Isla7940-s/mechanical-engineering/ball-valve/video/img/body.jpg

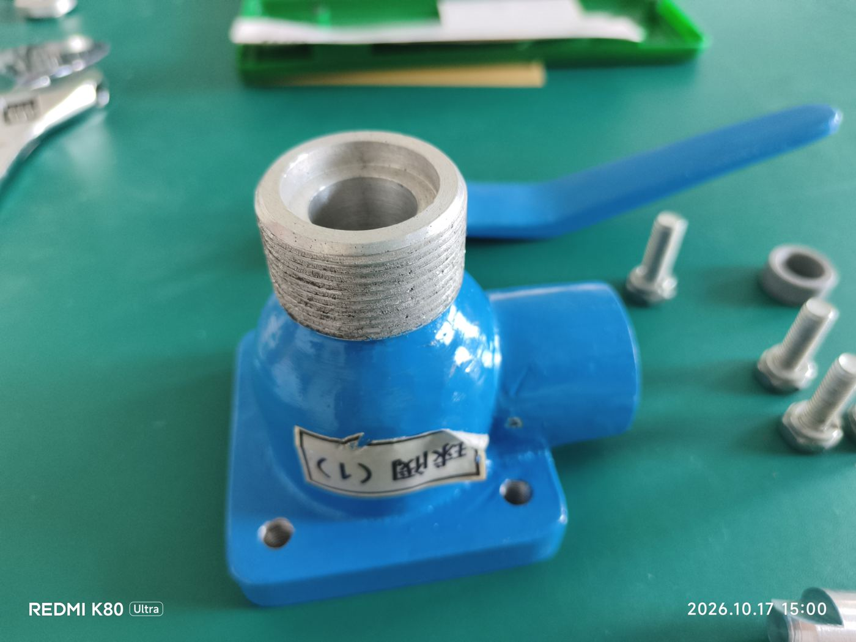
ball-valve/video/img/body.jpg
