Isla7940-s/mechanical-engineering/ball-valve/video-iphone4/img/cover_caliper.jpg

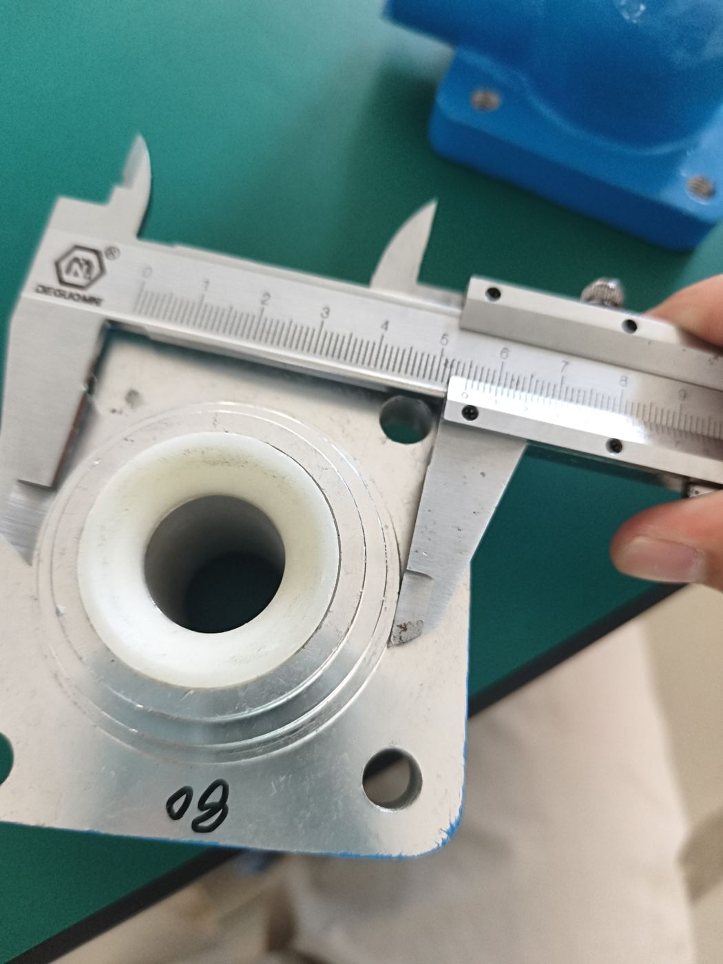
ball-valve/video-iphone4/img/cover_caliper.jpg
