Isla7940-s/mechanical-engineering/README.md

# mechanical-engineering
Repository for mechanical engineering projects, designs, and documentation.
