Isla7940-s/mechanical-engineering/ball-valve/cad/renders/球阀_模型效果图.png

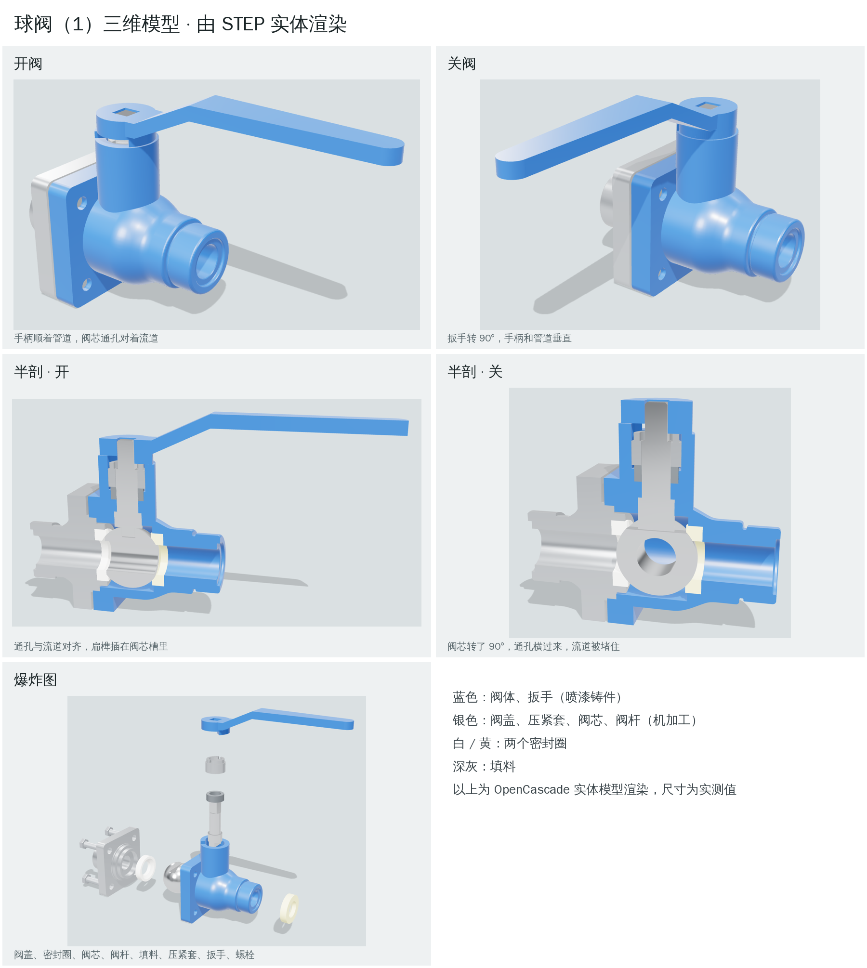
ball-valve/cad/renders/球阀_模型效果图.png
