Isla7940-s/mechanical-engineering/ball-valve/cad/renders/球阀_零件模型图.png

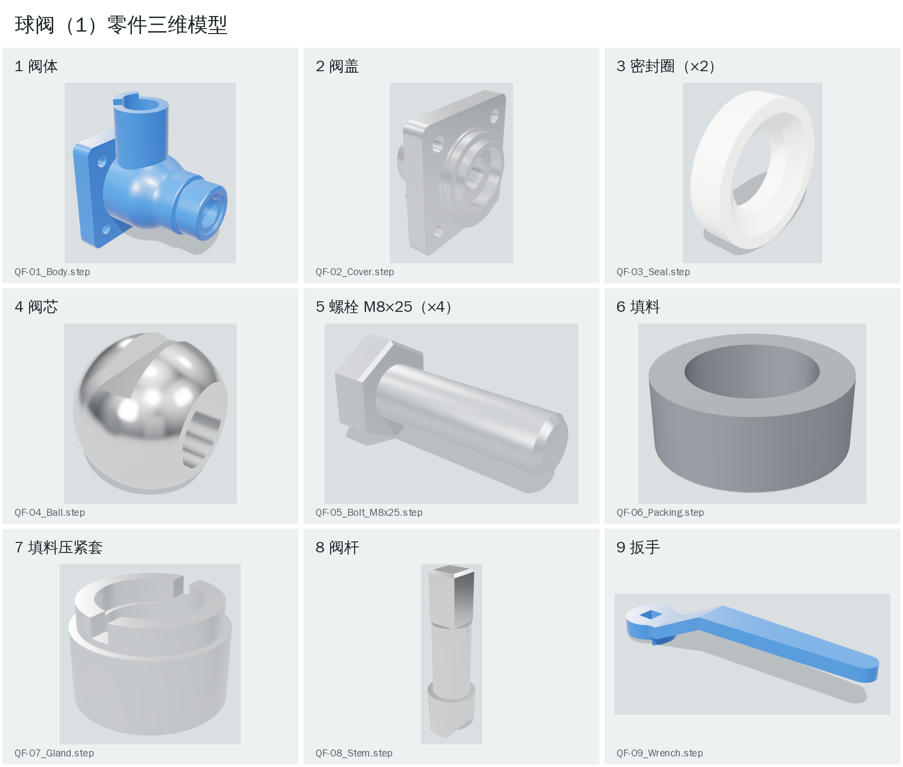
ball-valve/cad/renders/球阀_零件模型图.png
