Isla7940-s/mechanical-engineering/ball-valve/video/img/wrench_caliper.jpg

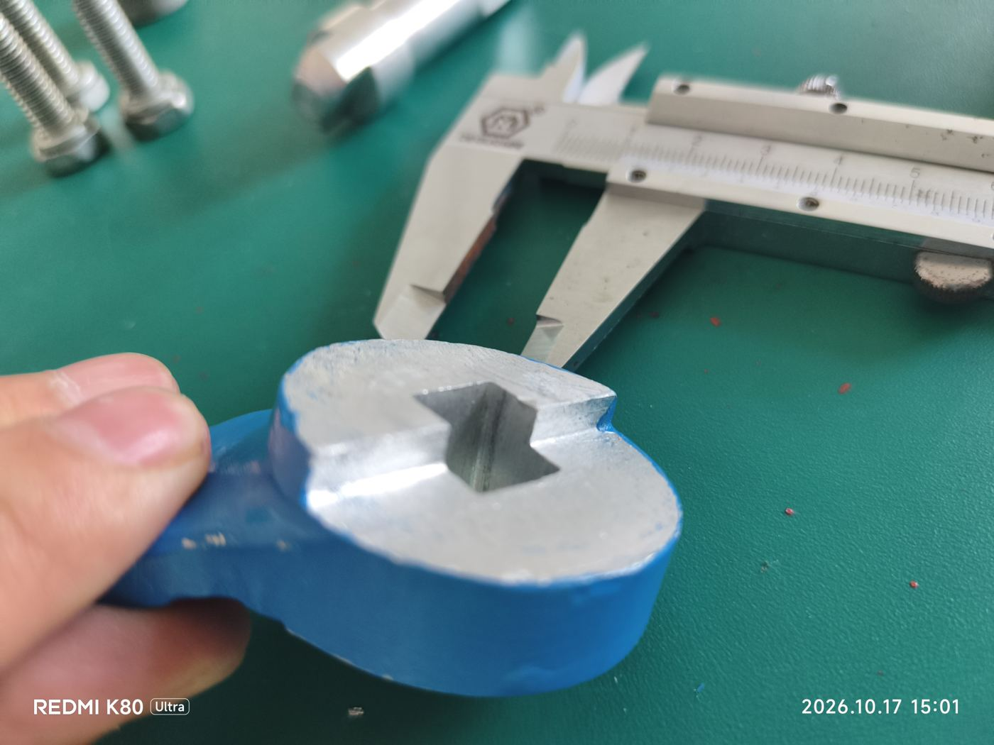
ball-valve/video/img/wrench_caliper.jpg
