Isla7940-s/mechanical-engineering/ball-valve/cad/step/QF-00_Ball_Valve_Assembly.step

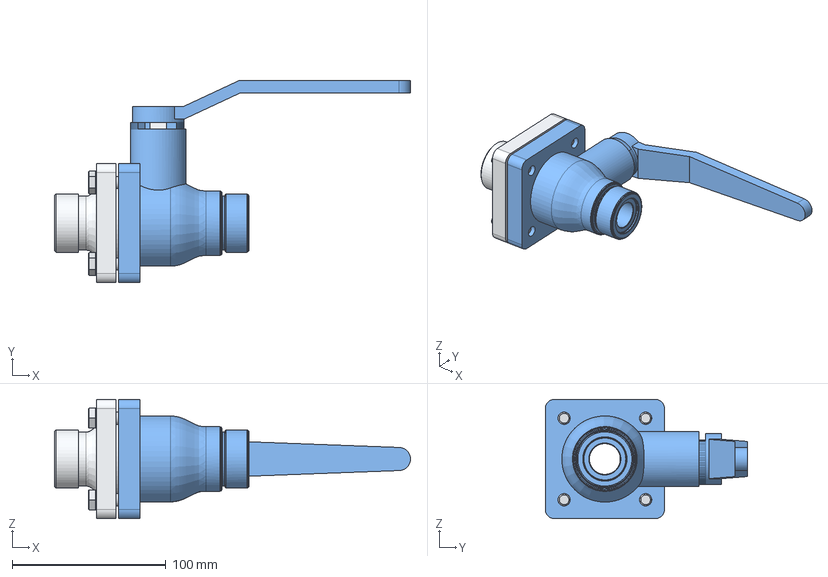
[picture p6: CAD file, 2026-10-21]
ball-valve/cad/step/QF-00_Ball_Valve_Assembly.step
231.4 x 131.6 x 77.5 mm
QF-01_Body
QF-02_Cover
QF-04_Ball
QF-06_Packing
QF-07_Gland
QF-08_Stem
QF-09_Wrench
QF-03_Seal-1
QF-03_Seal-2
QF-05_Bolt-1 x 4
