Isla7940-s/mechanical-engineering/ball-valve/cad/dxf/QF-08_阀杆.dxf

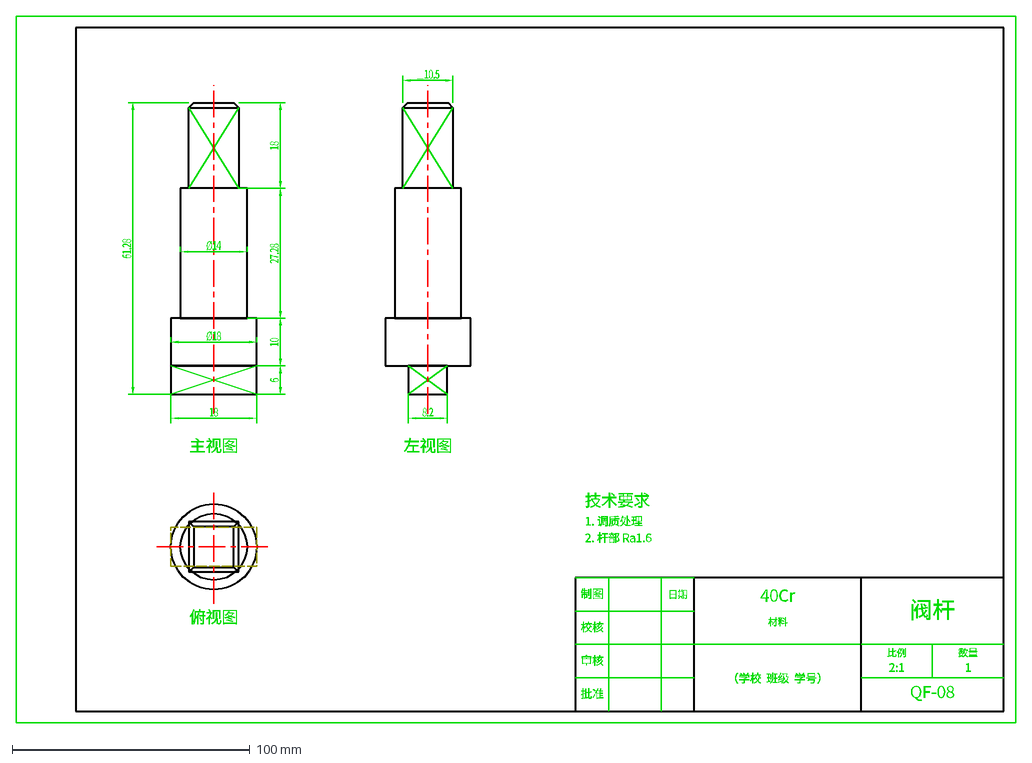
[picture p7: CAD file, 2026-10-21]
ball-valve/cad/dxf/QF-08_阀杆.dxf
61.28
6
10
27.28
18
Ø14
Ø18
主视图
8.2
□10.5
左视图
俯视图
批准
审核
校核
制图
日期
40Cr
材料
（学校 班级 学号）
阀杆
比例
2:1
数量
1
QF-08
技术要求
1. 调质处理
2. 杆部 Ra1.6
