Isla7940-s/mechanical-engineering/ball-valve/cad/step/QF-06_Packing.step

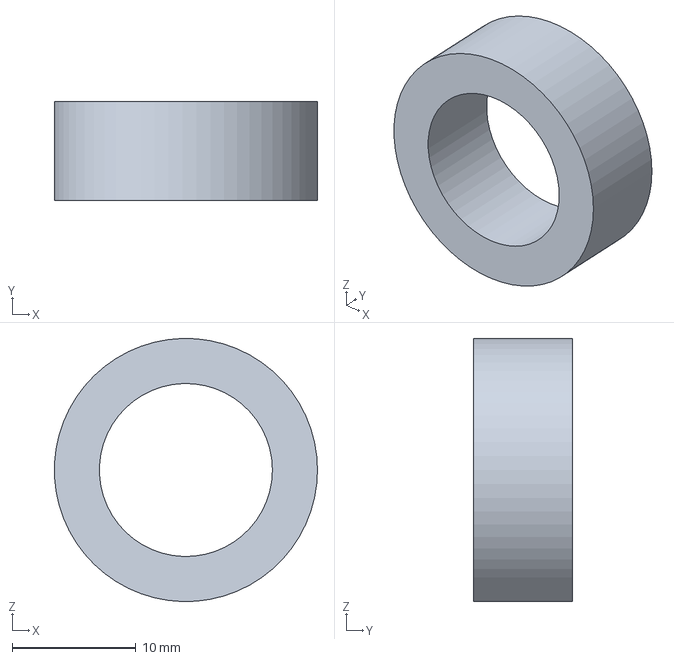
[picture p8: CAD file, 2026-10-21]
ball-valve/cad/step/QF-06_Packing.step
21.3 x 8.00 x 21.3 mm
