Isla7940-s/mechanical-engineering/ball-valve/cad/dxf/QF-03_密封圈.dxf

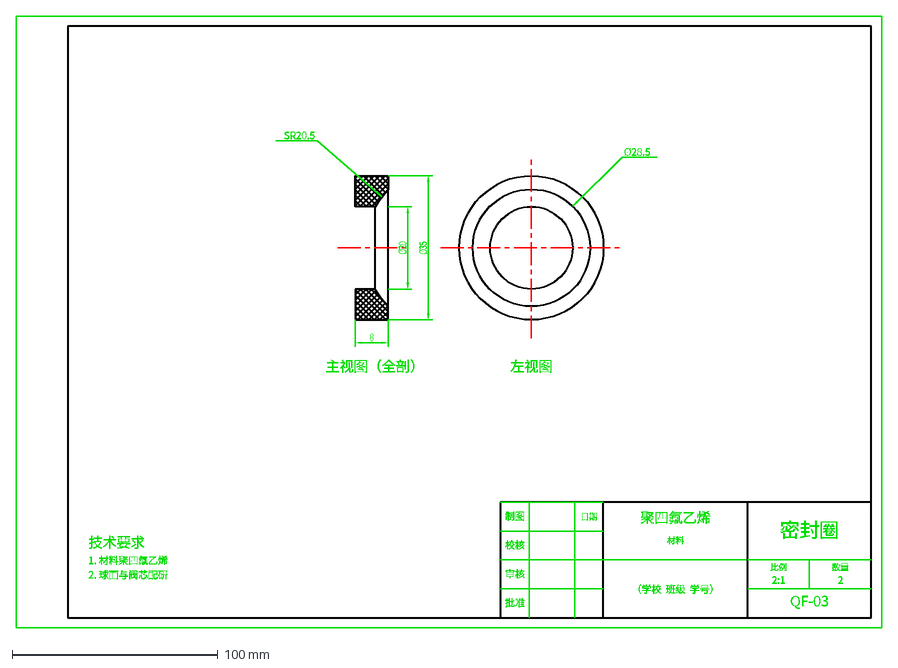
[picture p9: CAD file, 2026-10-21]
ball-valve/cad/dxf/QF-03_密封圈.dxf
8
Ø20
Ø35
SR20.5
主视图（全剖）
Ø28.5
左视图
批准
审核
校核
制图
日期
聚四氟乙烯
材料
（学校 班级 学号）
密封圈
比例
2:1
数量
2
QF-03
技术要求
1. 材料聚四氟乙烯
2. 球面与阀芯配研
