Isla7940-s/mechanical-engineering/ball-valve/cad/dxf/QF-02_阀盖.dxf

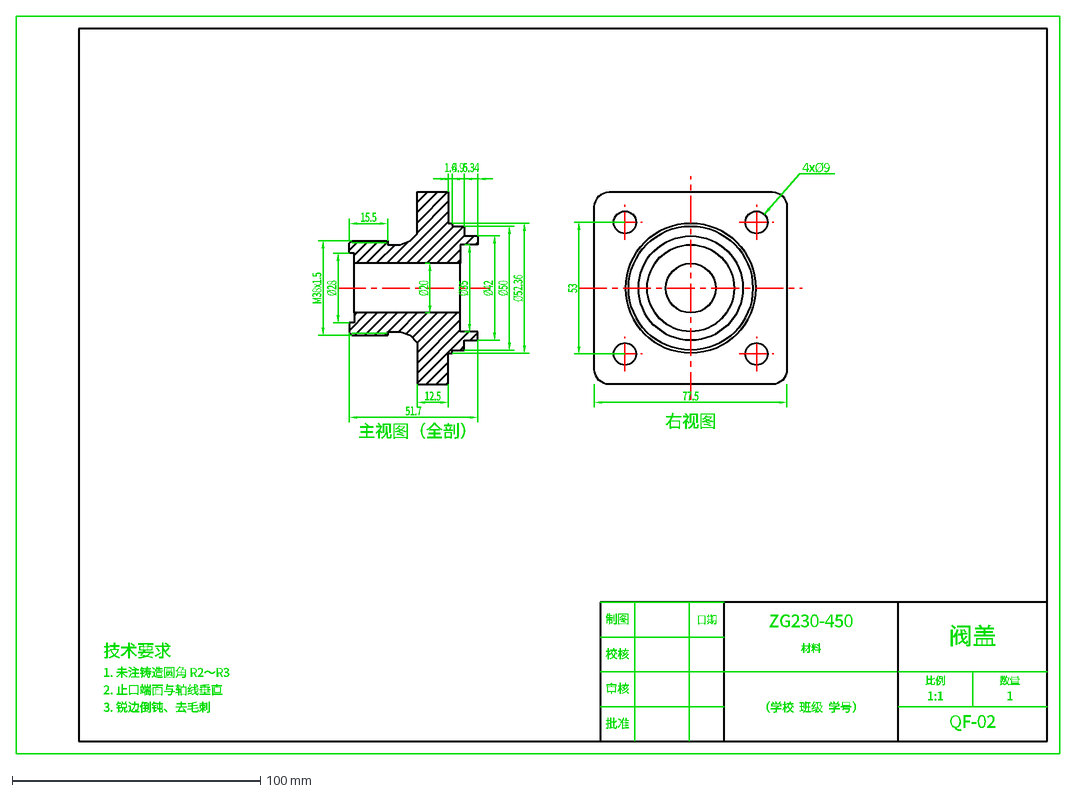
[picture p10: CAD file, 2026-10-21]
ball-valve/cad/dxf/QF-02_阀盖.dxf
51.7
12.5
1.6
4.9
5.34
Ø42
Ø50
Ø52.36
Ø35
Ø20
Ø28
M38x1.5
15.5
主视图（全剖）
77.5
53
4xØ9
右视图
批准
审核
校核
制图
日期
ZG230-450
材料
（学校 班级 学号）
阀盖
比例
1:1
数量
1
QF-02
技术要求
1. 未注铸造圆角 R2～R3
2. 止口端面与轴线垂直
3. 锐边倒钝、去毛刺
