Isla7940-s/mechanical-engineering/ball-valve/cad/step/QF-02_Cover.step

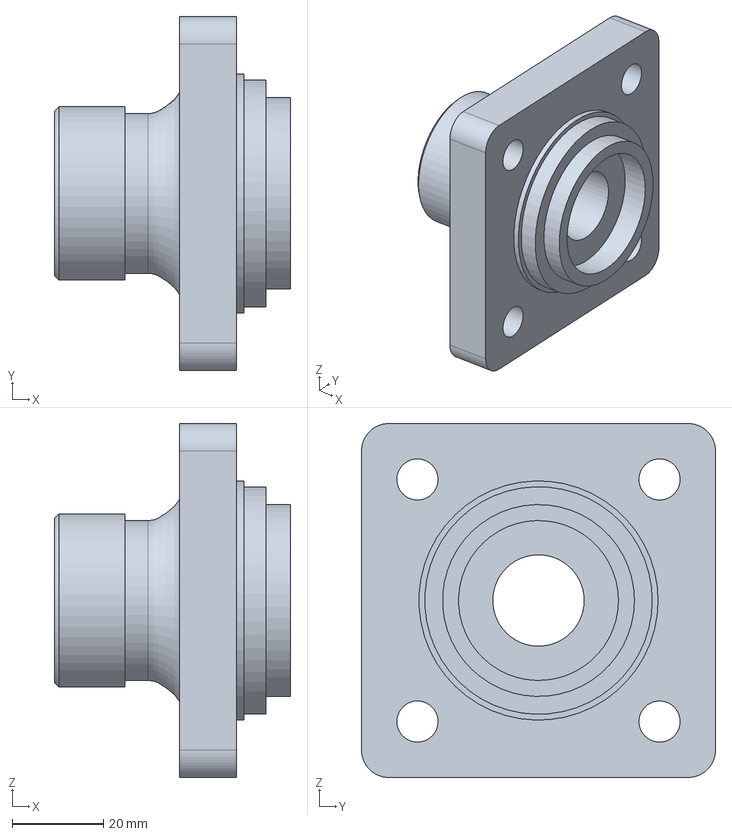
[picture p11: CAD file, 2026-10-21]
ball-valve/cad/step/QF-02_Cover.step
51.7 x 77.5 x 77.5 mm
