Isla7940-s/mechanical-engineering/ball-valve/cad/dxf/QF-01_阀体.dxf

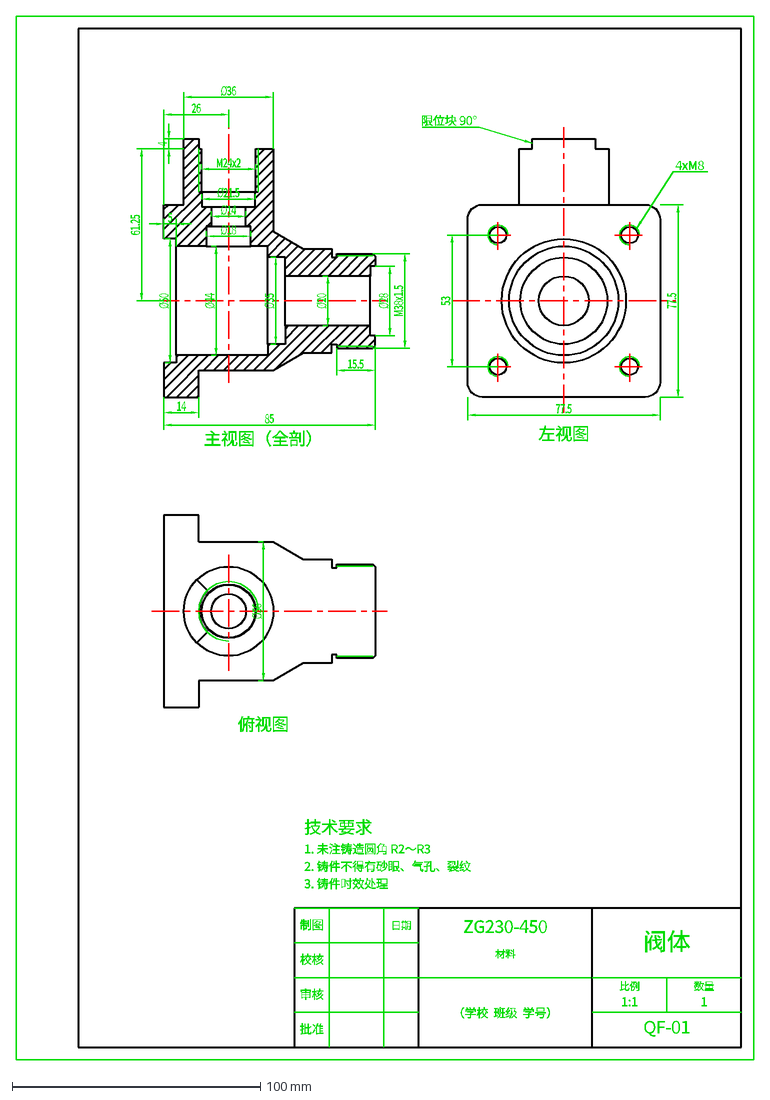
[picture p12: CAD file, 2026-10-21]
ball-valve/cad/dxf/QF-01_阀体.dxf
85
14
26
Ø36
61.25
4
Ø50
5
Ø44
Ø35
Ø20
Ø28
M38x1.5
15.5
Ø18
Ø14
Ø21.5
M24x2
主视图（全剖）
77.5
53
4xM8
限位块 90°
左视图
Ø56
俯视图
批准
审核
校核
制图
日期
ZG230-450
材料
（学校 班级 学号）
阀体
比例
1:1
数量
1
QF-01
技术要求
1. 未注铸造圆角 R2～R3
2. 铸件不得有砂眼、气孔、裂纹
3. 铸件时效处理
