Isla7940-s/mechanical-engineering/ball-valve/cad/dxf/QF-00_球阀装配图.dxf

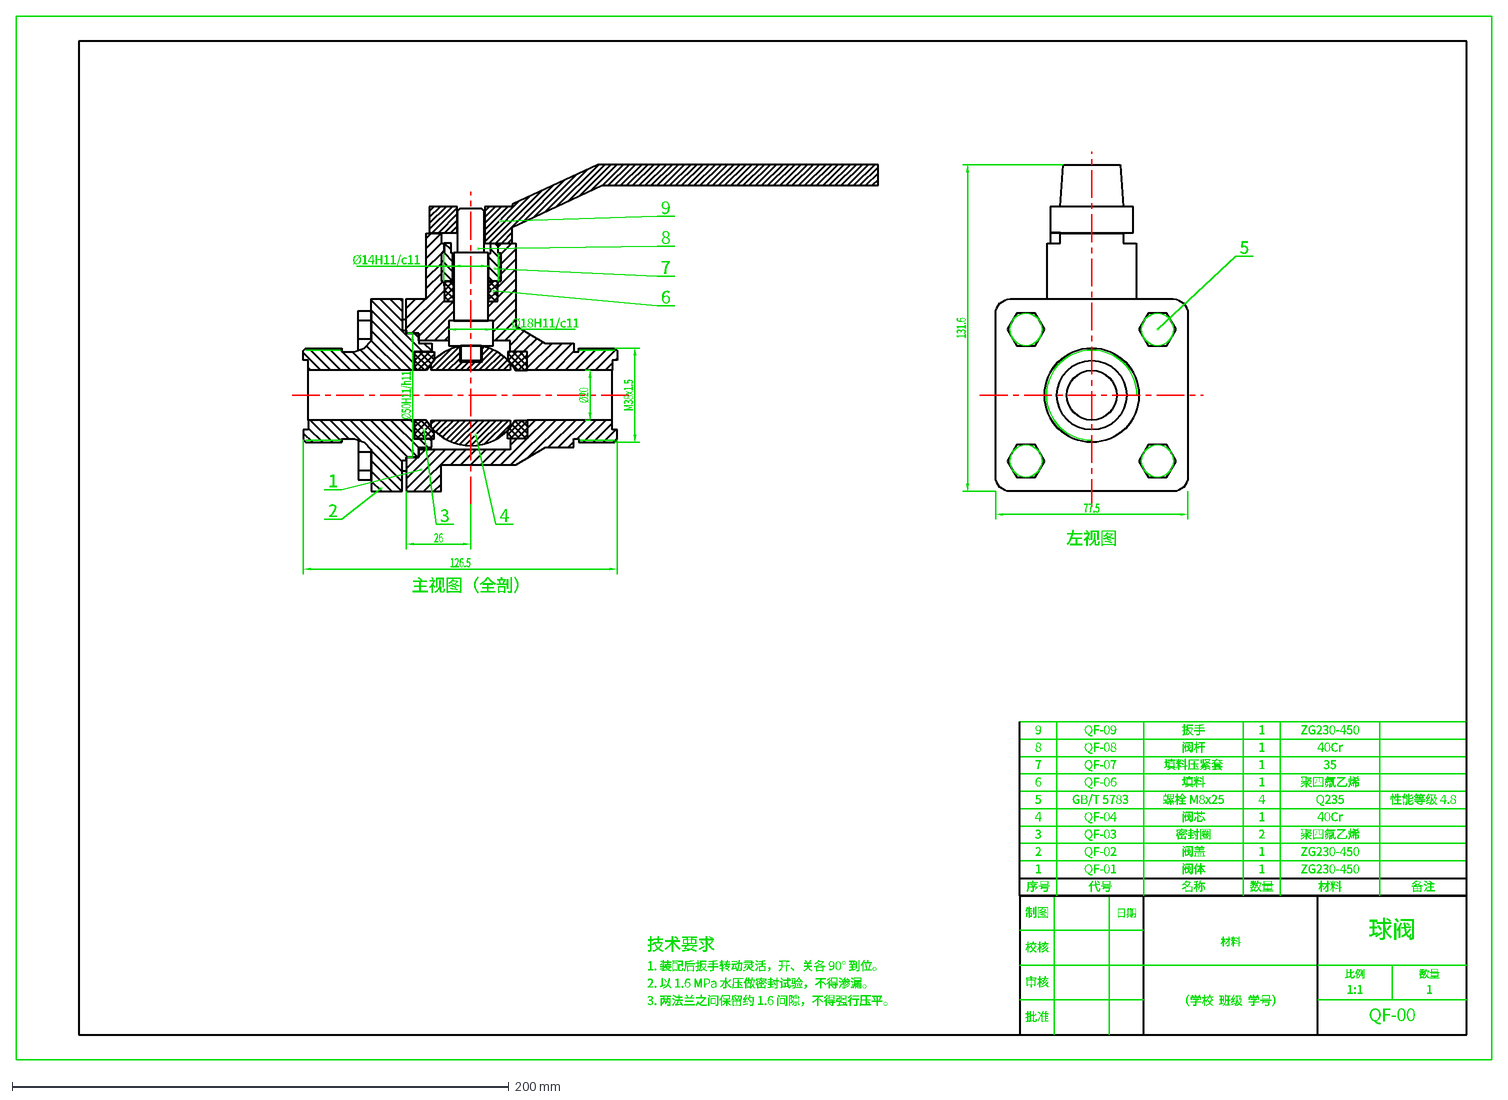
[picture p13: CAD file, 2026-10-21]
ball-valve/cad/dxf/QF-00_球阀装配图.dxf
126.5
26
Ø20
M38x1.5
Ø50H11/h11
Ø14H11/c11
Ø18H11/c11
1
2
3
4
6
7
8
9
主视图（全剖）
77.5
131.6
5
左视图
批准
审核
校核
制图
日期
材料
（学校 班级 学号）
球阀
比例
1:1
数量
QF-00
序号
代号
名称
备注
QF-01
阀体
ZG230-450
QF-02
阀盖
QF-03
密封圈
聚四氟乙烯
QF-04
阀芯
40Cr
GB/T 5783
螺栓 M8x25
Q235
性能等级 4.8
QF-06
填料
QF-07
填料压紧套
35
QF-08
阀杆
QF-09
扳手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
