Isla7940-s/mechanical-engineering/ball-valve/cad/step/QF-09_Wrench.step

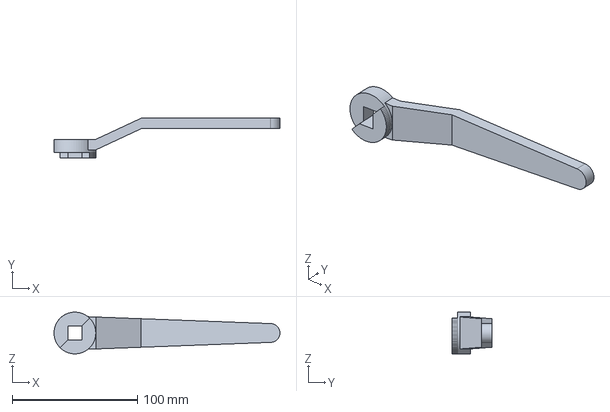
[picture p14: CAD file, 2026-10-21]
ball-valve/cad/step/QF-09_Wrench.step
180.7 x 31.6 x 33.4 mm
