Isla7940-s/mechanical-engineering/ball-valve/cad/dxf/QF-07_填料压紧套.dxf

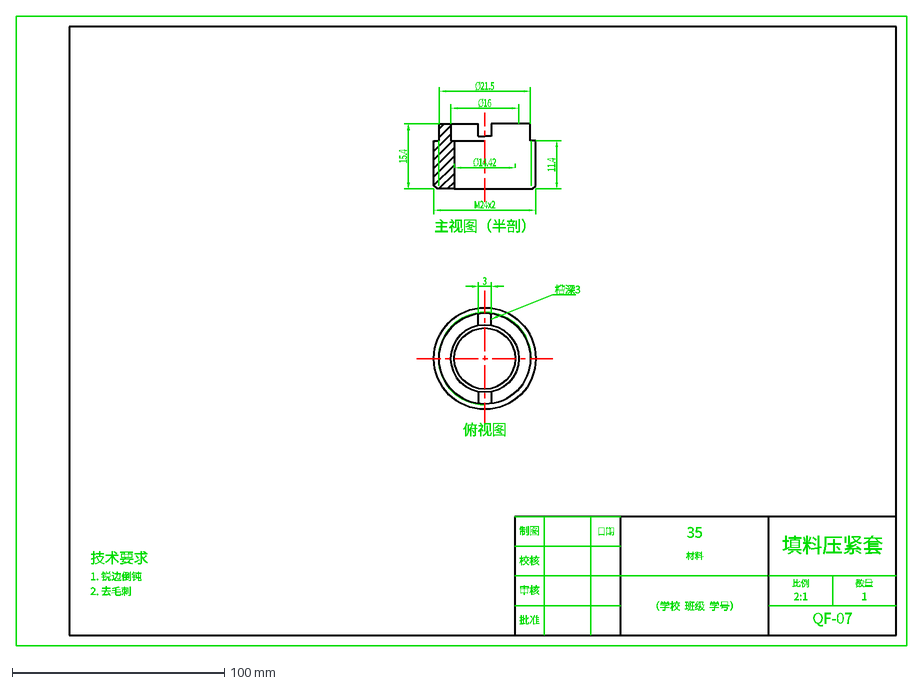
[picture p15: CAD file, 2026-10-21]
ball-valve/cad/dxf/QF-07_填料压紧套.dxf
15.4
11.4
M24x2
Ø14.42
Ø16
Ø21.5
主视图（半剖）
3
槽深3
俯视图
批准
审核
校核
制图
日期
35
材料
（学校 班级 学号）
填料压紧套
比例
2:1
数量
1
QF-07
技术要求
1. 锐边倒钝
2. 去毛刺
