Isla7940-s/mechanical-engineering/ball-valve/cad/step/QF-03_Seal.step

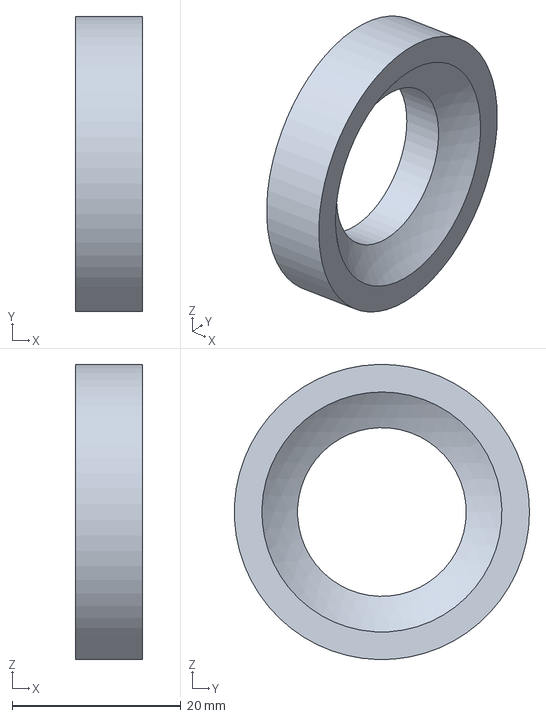
[picture p16: CAD file, 2026-10-21]
ball-valve/cad/step/QF-03_Seal.step
8.00 x 35.0 x 35.0 mm
