Isla7940-s/mechanical-engineering/ball-valve/cad/dxf/QF-09_扳手.dxf

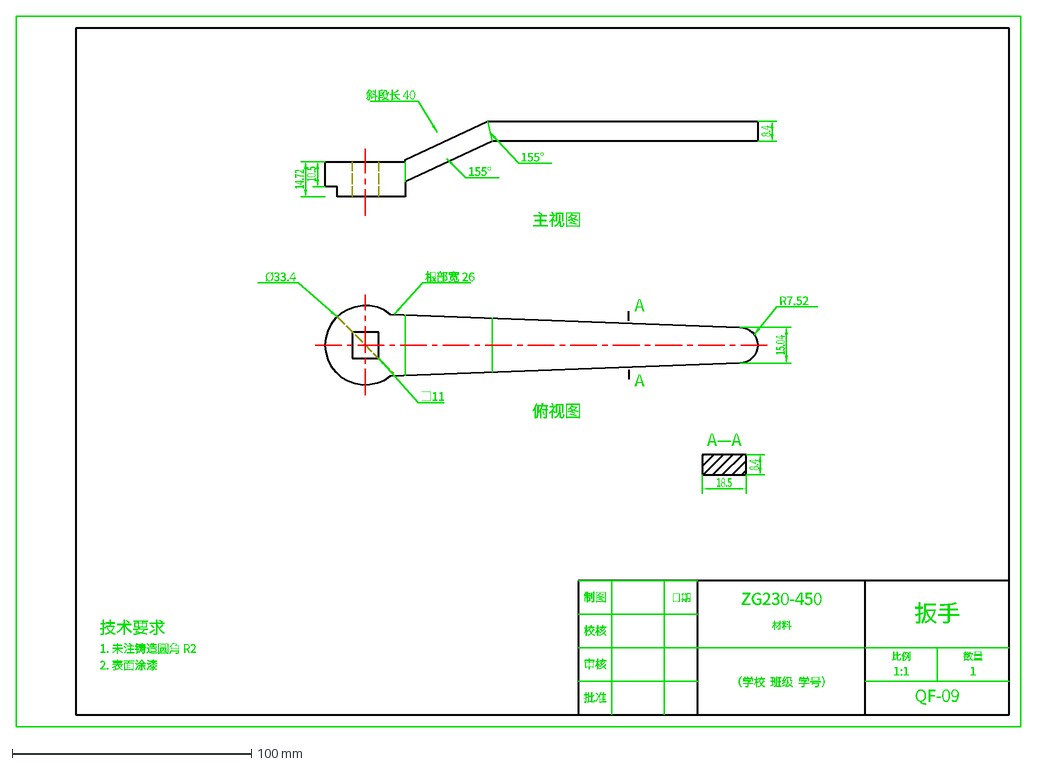
[picture p17: CAD file, 2026-10-21]
ball-valve/cad/dxf/QF-09_扳手.dxf
14.72
10.5
8.4
155°
斜段长 40
主视图
A
Ø33.4
□11
R7.52
15.04
根部宽 26
俯视图
18.5
A—A
批准
审核
校核
制图
日期
ZG230-450
材料
（学校 班级 学号）
扳手
比例
1:1
数量
1
QF-09
技术要求
1. 未注铸造圆角 R2
2. 表面涂漆
