Isla7940-s/mechanical-engineering/ball-valve/cad/step/QF-01_Body.step

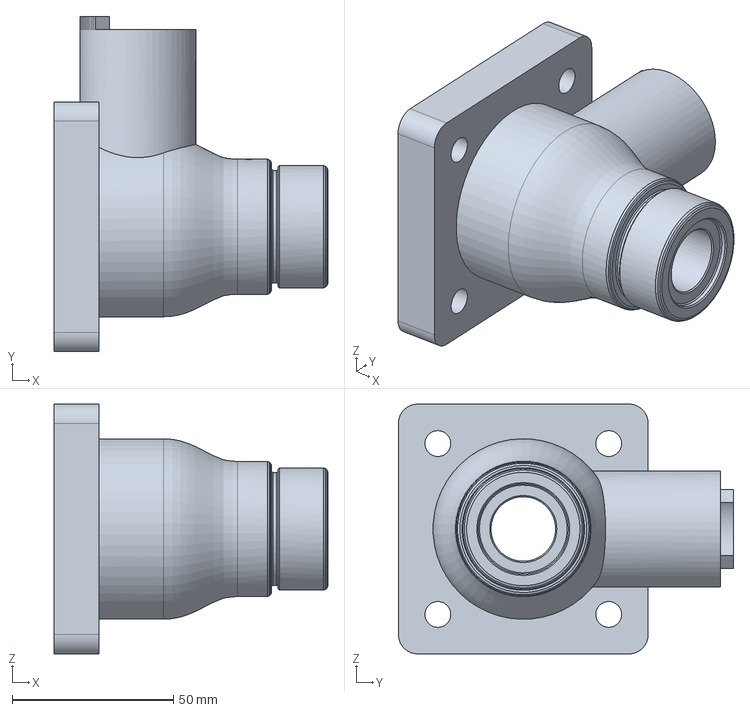
[picture p18: CAD file, 2026-10-21]
ball-valve/cad/step/QF-01_Body.step
85.0 x 104.0 x 77.5 mm
