Isla7940-s/mechanical-engineering/ball-valve/cad/dxf/QF-04_阀芯.dxf

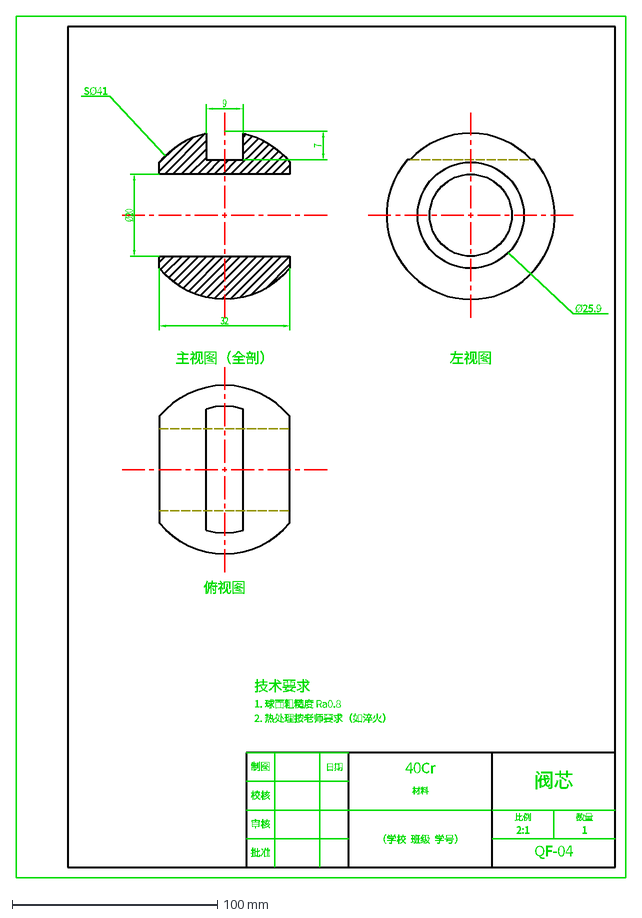
[picture p19: CAD file, 2026-10-21]
ball-valve/cad/dxf/QF-04_阀芯.dxf
32
Ø20
SØ41
9
7
主视图（全剖）
Ø25.9
左视图
俯视图
批准
审核
校核
制图
日期
40Cr
材料
（学校 班级 学号）
阀芯
比例
2:1
数量
1
QF-04
技术要求
1. 球面粗糙度 Ra0.8
2. 热处理按老师要求（如淬火）
