Isla7940-s/mechanical-engineering/ball-valve/cad/step/QF-04_Ball.step

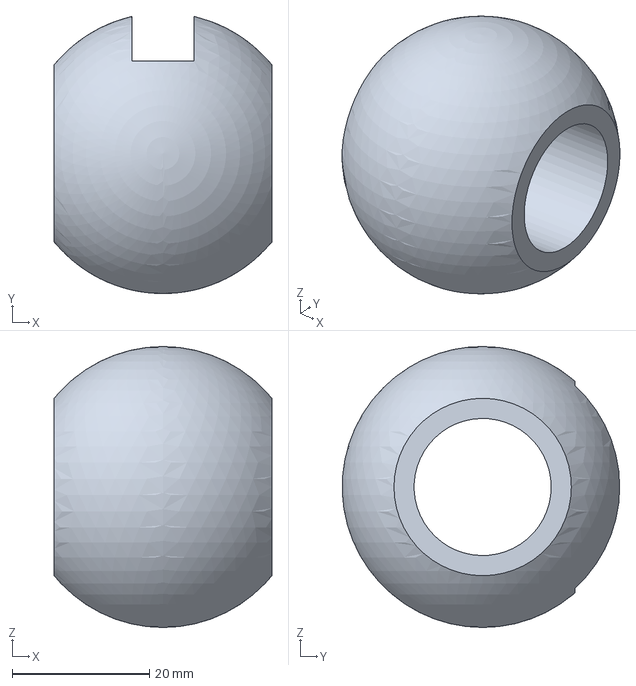
[picture p20: CAD file, 2026-10-21]
ball-valve/cad/step/QF-04_Ball.step
31.8 x 40.5 x 41.0 mm
