Isla7940-s/mechanical-engineering/ball-valve/cad/step/QF-08_Stem.step

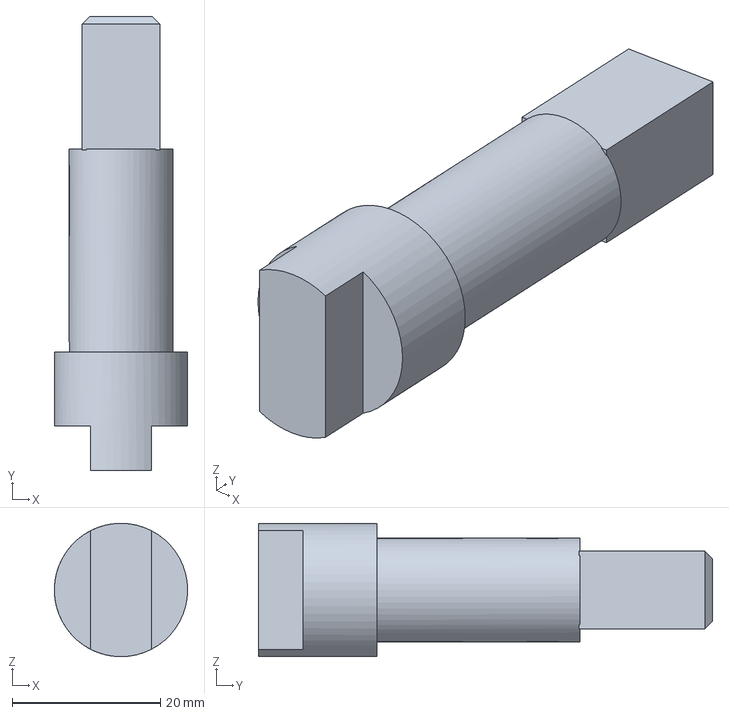
[picture p21: CAD file, 2026-10-21]
ball-valve/cad/step/QF-08_Stem.step
18.0 x 61.3 x 18.0 mm
