Isla7940-s/mechanical-engineering/ball-valve/cad/step/QF-07_Gland.step

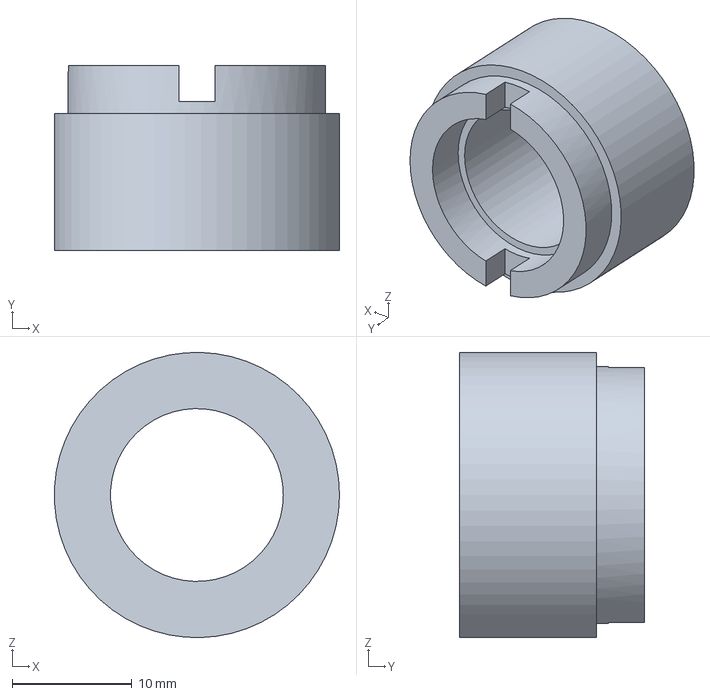
[picture p22: CAD file, 2026-10-21]
ball-valve/cad/step/QF-07_Gland.step
23.8 x 15.4 x 23.8 mm
