Isla7940-s/mechanical-engineering/ball-valve/cad/step/QF-05_Bolt_M8x25.step

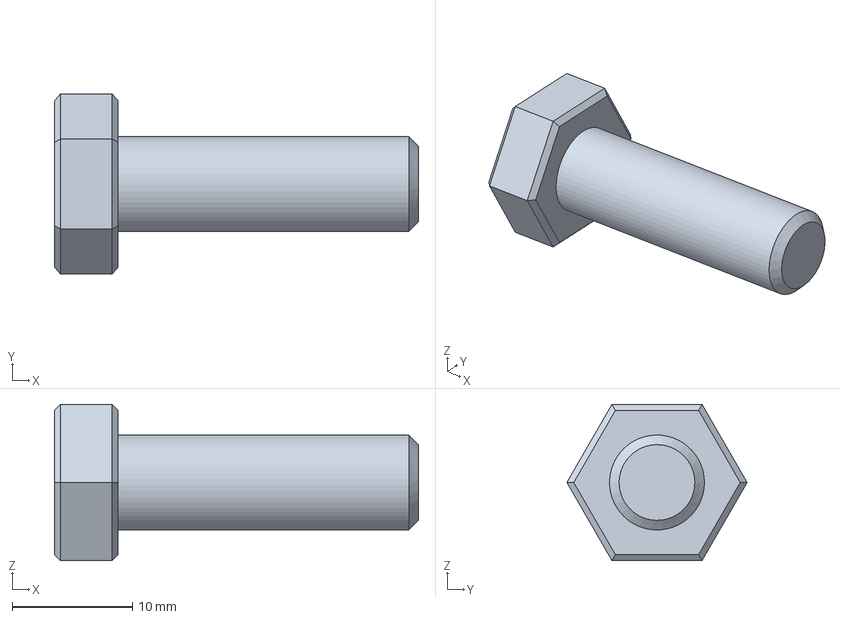
[picture p23: CAD file, 2026-10-21]
ball-valve/cad/step/QF-05_Bolt_M8x25.step
30.3 x 15.0 x 13.0 mm
