Isla7940-s/mechanical-engineering/(commit log)

2026-10-17 Add ball valve measurement handbook page
    Interactive 3D disassembly, per-part sketch views, assembly drawing
    and full workflow for the ball valve drafting course project.
    Claude-Session: https://claude.ai/code/session_015tyMG3tLgM31LjtfCBwBFR
2026-10-17 Update ball valve handbook with measured dimensions
    Redraw 3D model, part sketches and assembly drawing from the measured
    data, add a dimension summary table, drop the gasket and washers that
    the real valve does not have, and remove coplanar faces that caused
    z-fighting in the 3D view.
    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
2026-10-17 Fix ball slot orientation: slot runs perpendicular to the bore
    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
2026-10-17 Rebuild 3D viewer with realistic rendering
    Environment lighting, tone mapping and soft shadows; painted vs machined
    materials; filleted profiles, modelled threads, true slot and tenon
    shapes; hatched section caps and optional edge outlines.
    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
2026-10-17 Tidy assembly drawing to drafting conventions
    Order balloons counterclockwise without crossing dimensions, pull fit
    dimensions out of the parts, move overall height to the left view, draw
    the bolt heads visible behind the section plane, correct the left-view
    handle projection, and add technical requirements, parts list and title
    block to the sheet.
    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
2026-10-21 Add CAD deliverables: STEP solids, DXF drawings, SolidWorks macro
    Solids are built with CadQuery from the measured dimensions and checked
    for interference and for the 90-degree wrench travel. DXF sheets reuse
    the page's drawing geometry with GB-style layers, frame, title block and
    parts list. The SolidWorks macro imports the STEP parts, builds the
    assembly and adds mates so the wrench, stem and ball turn together.
    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
    [QF-00_Ball_Valve_Assembly.step, QF-00_球阀装配图.dxf, QF-01_Body.step, QF-01_阀体.dxf, QF-02_Cover.step, QF-02_阀盖.dxf, QF-03_Seal.step, QF-03_密封圈.dxf]
2026-10-21 Add rendered images of the ball valve solids
    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
2026-10-21 Add launch-style video page: sketch to CAD to 3D
    A 72-second scripted timeline in HTML: measurements, the assembly
    drawing drawn in as a sketch, recoloured into CAD layers, then matched
    to the STEP solids in the same view with hatched stencil section caps,
    exploded, and turned 90 degrees to close.
    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
2026-10-21 Add iPhone 4 style product film for the ball valve
    White studio, floor reflection, thin type; hero orbit, wrench and flange
    close-ups, labelled exploded view, 126.5 mm length beat, section with
    90-degree close, a 'one more thing' caliper beat on black, end card.
    Reuses the video/ model bundle via a symlink.
    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
